pajotsetrapper/PicoMotics/doc/central-unit.jpg

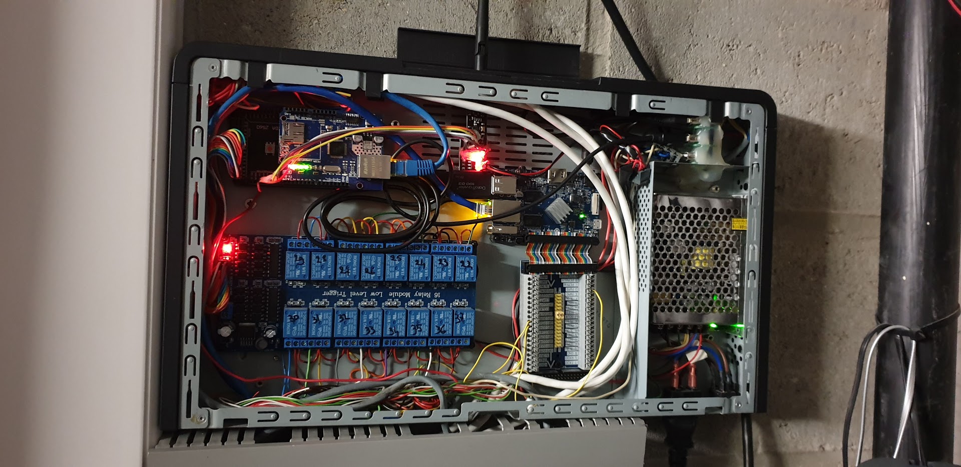
doc/central-unit.jpg
