pajotsetrapper/PicoMotics/doc/screenshot-solar-monitoring.png

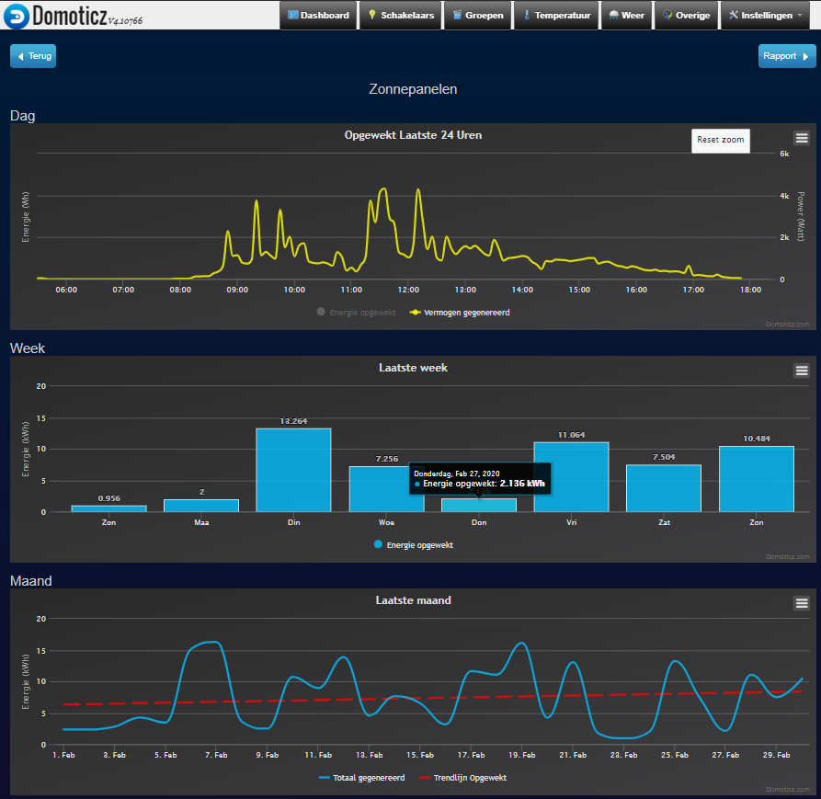
doc/screenshot-solar-monitoring.png
