pajotsetrapper/PicoMotics/doc/conceptual-overview.pdf

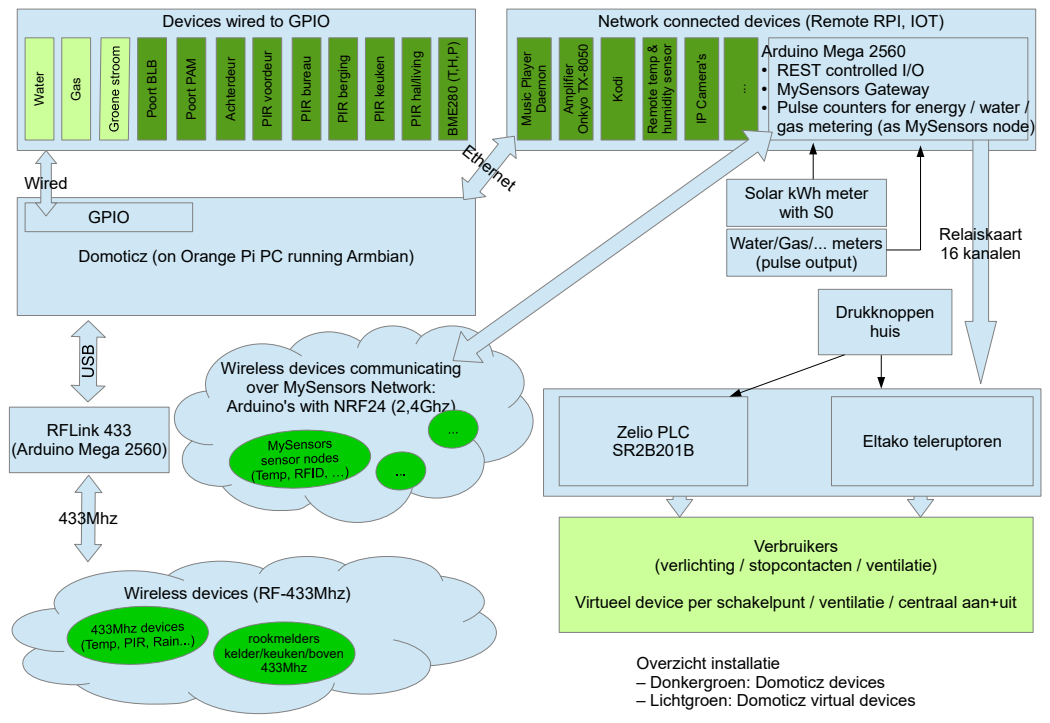
[picture p3: page 1]
ater; ort B; ort PA; hterd; PIR; ord; al/livin; ure; ergin; RFLink 433 (Arduino Mega 2560); GPIO; rookmelders kelder/keuken/boven 433Mhz; Wired; 433Mhz; sic; Pla; plifier; ote te; midity; Ethernet; Verbruikers; era's; Relaiskaart 16 kanalen; Drukknoppen huis; Arduino Mega 2560 ● REST controlled I/O

Devices wired to GPIO

Network connected devices (Remote RPI, IOT)

● MySensors Gateway
● Pulse counters for energy / water /

gas metering (as MySensors node)

Solar kWh meter
with S0
Water/Gas/... meters
(pulse output)

Domoticz (on Orange Pi PC running Armbian)

Wireless devices communicating
over MySensors Network:
Arduino's with NRF24 (2,4Ghz)

Eltako teleruptoren Zelio PLC

(verlichting / stopcontacten / ventilatie)

Wireless devices (RF-433Mhz)

Virtueel device per schakelpunt / ventilatie / centraal aan+uit

Overzicht installatie
– Donkergroen: Domoticz devices
– Lichtgroen: Domoticz virtual devices
