pajotsetrapper/PicoMotics/(commit log)

2020-03-01 Added screenshot of Solar power generation chart (Domoticz)
2020-03-02 Level shifter required for SDA/SCL on 5V arduino's
2020-10-04 Implement class for door contact / motion sensors
2020-12-27 No pull-up for PIR sensors
2020-12-27 Only use currently wired sensors
2020-12-27 Add logging for Sensor presentation / send update
2020-12-27 Bugfix: corrected constructor of Sensor class
    [centralNode.ino]
2021-11-20 Script to auto-create virtual Domoticz devices
2021-11-26 update device name
2021-11-26 update device names
2021-12-05 Fix: only use supported timer values
2022-04-01 Increase gas sensor debounce to 2s
2022-04-01 Increase gas sensor debounce to 3.5s
2022-09-02 Create user var for gas power calculation during pvOutput uploads
2025-02-01 Update script to read humidity from an MQTT import device
